osu-uwrt/gyro_cal_rig/(commit log)

2024-07-02 added driver node
2024-07-03 fixed rig driver, started cal node
    [arduino_driver.ino, gyro_calibration_node.py, gyro_rig_node.cpp]
2024-07-08 add plotjuggler layout and fix gui
    [main.cpp]
2024-07-13 added heating capabilities to arduino
2024-07-17 gyro calibration script works for high data quantities
2024-07-20 add calibration procedure
2024-07-20 ready for automated validation with odometry
2024-07-20 fix validation freezing issue
    [arduino_driver.ino, gyro_validation_node.py]
2024-07-22 added rig calibration and gyro validation analysis
2024-07-22 add rig recording launch, little changes, and slightly different gear ratio
2024-07-24 better analysis of gyro drift and error scalar factor
2024-07-30 add new calibration procedure and scale factor analysis for validation
2024-07-31 heat while waiting to heat
2024-08-01 calibration2 analysis lookin fire
2024-10-04 gears changed, update magical number
2024-10-04 theoretically working averaging for calibration2
